ultrazohm/uz_ext_voltage_measurement_15kv/BOM_Spannungsmessung_15kV_Stückliste.pdf

Name | Description | Quantity | Manufacturer | Manufacturer Part Number | Supplyer | Supplier Part Number
Kondensatoren
1 µF | 50V 1uF X5R ±10% 0603 Multilayer Ceramic Capacitors MLCC - SMD/SMT ROHS | 13 | Samsung | CL10A105KB8NNNC | Mouser | 187-CL10A105KB8NNNC
1600 pF | Capacitor 1206, 25V, 1600pF, X8R, 10% | 2 | KEMET | C1206C162K3HACTU | Mouser | 80-C1206C162K3HACTU
15 pF | Capacitor 0805, 25 VDC, 15 pF, X7R | 2 | Kyocera AVX | 08053C150KAT2A | Mouser | 581-08053C150KAT2A
1000 pF | Capacitor 1206, 200VDC, 1000pF, C0G, 5% | 150 | KEMET | C1206C102J2GACTU | Mouser | 80-C1206C102J2G
1 µF | Capacitor 1206, 25V, 1uF, X7R, 5% | 2 | KEMET | C1206C105J3RACAUTO | Mouser | 80-C1206C105J3RCAUTO
100 nF | Capacitor 0603, 6.3 VDC, 100 nF, X5R | 4 | KEMET | C0603C104K9PACTU | Mouser | 80-C0603C104K9P
82k | SMD resistor 82Kohms .1% 25ppm | 150 | Vishay Dale | TNPW120682K0BEEA | Mouser | 71-TNPW120682K0BEEA
10R | SMD 1/10watt 10ohms 1% | 2 | Vishay | CRCW060310R0FKTA | Mouser | 71-CRCW0603-10
82R | SMD resistor 1/4W 82 ohm .1% 25ppm | 2 | Yageo | RT1206BRD0782RL | Mouser | 603-RT1206BRD0782RL
49R9 | 100mW Thick Film Resistors ±100ppm/℃ ±1% 49.9Ω 0603 Chip Resistor - Surface Mount ROHS | 2 | Yageo | RC0603FR-0749R9L | Mouser | 603-RC0603FR-0749R9L
3k 0.1% | Resistor - SMD 1206 3.0Kohm 0.1% 25ppm | 2 | Panasonic | ERA-8AEB302V | Mouser | 667-ERA-8AEB302V
1k 0.1% | Resistor - SMD 1206 1.0Kohm 0.1% 15ppm | 2 | Panasonic | ERA-8APB102V | Mouser | 667-ERA-8APB102V
1SS356VMFHTE-17 | Dioden (Allzweck, Leistung, Schaltung) SWITCHING DIODE 35V | 4 | Rohm | 1SS356VMFHTE-17 | Mouser | 755-1SS356VMFHTE-17
SI8920BC-IP | Integrated Circuit - Trennverstärker Isolated analog amplifier with 200 mV input | 1 | Silicon Labs | SI8920BC-IP | Mouser | 634-SI8920BC-IP
ADA4940-1ARZ-R7 | Differential ADC Driver | 1 | Analog Devices | ADA4940-1ARZ-R7 | Mouser | 584-ADA4940-1ARZ-R7
EC3SAW-24S05HP | Isolierte DC/DC-Wandler – Durchsteckmontage 3W 9-36Vin 5Vout 600mA | 1 | Cincon | EC3SAW-24S05HP | Mouser | 418-EC3SAW-24S05HP
EC3SAW-24D05HP | Isolierte DC/DC-Wandler – Durchsteckmontage 3W 9-36Vin +/-5Vout 300mA | 1 | Cincon | EC3SAW-24D05HP | Mouser | 418-EC3SAW-24D05HP
M8 Connector | 7460719_M8 | 2 | Wurth Electronics | 7460719 | Mouser | 710-7460719
BNC-Buchse | BNC5-J-P-GN-ST-TH2D | 2 | Samtec | BNC5-J-P-GN-ST-TH2D | Mouser | 200-BNC5JPGNSTTH2D
RJ45 Connector | RJHSE-5381 | 1 | Amphenol Commercial RJHSE-5381 | | Mouser | 523-RJHSE-5381
Laborbuchse red | FCR7350B, 1000V, 24A, RED | 2 | Cliff | FCR7350R | Farnell | 1854508
Laborbuchse Schwarz | FCR7350B, 1000V, 24A, BLACK | 2 | Cliff | FCR7350B | Farnell | 1854507

Stückliste Spannungsmessung 15 kV

Widerstände

Diode

IC's

DC/DC Wandler

Connectors
