ultrazohm/uz_ext_voltage_measurement_15kv/00_Stückliste_Spannungsmessung_15kV.xlsx

Stückliste Projekt Spannungsmessung 15 kV
Name | Description | Stk. | Manufacturer | Manufacturer Part Number | Supplier | Supplier Part Number | Euro/Stk. | Stk. Total | Lieferbar/Bestellt | geliefert
Kondensatoren |  |  |  |  |  |  |  |  | 3
1 µF | 50V 1uF X5R ±10% 0603 Multilayer Ceramic Capacitors MLCC - SMD/SMT ROHS | 13 | Samsung | CL10A105KB8NNNC | Mouser | 187-CL10A105KB8NNNC | 0.13 | 1.64 |  | 39
1600 pF | Capacitor 1206, 25V, 1600pF, X8R, 10% | 2 | KEMET | C1206C162K3HACTU | Mouser | 80-C1206C162K3HACTU | 0.16 | 0.32 |  | 6
15 pF | Capacitor 0805, 25 VDC, 15 pF, X7R | 2 | Kyocera AVX | 08053C150KAT2A | Mouser | 581-08053C150KAT2A | 0.19 | 0.38 |  | 6
1000 pF | Capacitor 1206, 200VDC, 1000pF, C0G, 5% | 150 | KEMET | C1206C102J2GACTU | Mouser | 80-C1206C102J2G | 0.24 | 36.45 | -> bei JLC Global Sourcing bestellen: Distributor TME (300 stk ~ 22$)
1 µF | Capacitor 1206, 25V, 1uF, X7R, 5% | 2 | KEMET | C1206C105J3RACAUTO | Mouser | 80-C1206C105J3RCAUTO | 0.35 | 0.70 |  | 6
100 nF | Capacitor 0603, 6.3 VDC, 100 nF, X5R | 4 | KEMET | C0603C104K9PACTU | Mouser | 80-C0603C104K9P | 0.16 | 0.65 |  | 12
Diode
1SS356VMFHTE-17 | Dioden (Allzweck, Leistung, Schaltung) SWITCHING DIODE 35V | 4 | Rohm | 1SS356VMFHTE-17 | Mouser | 755-1SS356VMFHTE-17 | 0.387 | 1.548 |  | 12
Widerstände
82k | SMD resistor 82Kohms .1% 25ppm | 150 | Vishay Dale | TNPW120682K0BEEA | Mouser | 71-TNPW120682K0BEEA | 0.319 | 47.85 | bei Mouser bestellt | 320
10R | SMD 1/10watt 10ohms 1% | 2 | Vishay | CRCW060310R0FKTA | Mouser | 71-CRCW0603-10 | 0.117 | 0.234 |  | 6
82R | SMD resistor 1/4W 82 ohm .1% 25ppm | 2 | Yageo | RT1206BRD0782RL | Mouser | 603-RT1206BRD0782RL | 0.585 | 1.17 |  | 10
49R9 | 100mW Thick Film Resistors ±100ppm/℃ ±1% 49.9Ω 0603 Chip Resistor - Surface Mount ROHS | 2 | Yageo | RC0603FR-0749R9L | Mouser | 603-RC0603FR-0749R9L | 0.09 | 0.18 |  | 10
3k 0.1% | Resistor - SMD 1206 3.0Kohm 0.1% 25ppm | 2 | Panasonic | ERA-8AEB302V | Mouser | 667-ERA-8AEB302V | 0.432 | 0.864 |  | 10
1k 0.1% | Resistor - SMD 1206 1.0Kohm 0.1% 15ppm | 2 | Panasonic | ERA-8APB102V | Mouser | 667-ERA-8APB102V | 0.801 | 1.602 |  | 6
IC's
SI8920BC-IP | Integrated Circuit - Trennverstärker Isolated analog amplifier with 200 mV input | 1 | Silicon Labs | SI8920BC-IP | Mouser | 634-SI8920BC-IP | 5.91 | 5.91 |  | 3
ADA4940-1ARZ-R7 | Differential ADC Driver | 1 | Analog Devices | ADA4940-1ARZ-R7 | Mouser | 584-ADA4940-1ARZ-R7 | 5.26 | 5.26 |  | 3
Spannungsversorgung
EC3SAW-24S05HP | Isolierte DC/DC-Wandler – Durchsteckmontage 3W 9-36Vin 5Vout 600mA | 1 | Cincon | EC3SAW-24S05HP | Mouser | 418-EC3SAW-24S05HP | 11,88 | 11,88 | hier noch auf lager
EC3SAW-24D05HP | Isolierte DC/DC-Wandler – Durchsteckmontage 3W 9-36Vin +/-5Vout 300mA | 1 | Cincon | EC3SAW-24D05HP | Mouser | 418-EC3SAW-24D05HP | 11,88 | 11,88 |  | 1
Verbindungsstücke
M8 Connector | 7460719_M8 | 2 | Wurth Electronics | 7460719 | Mouser | 710-7460719 | 6.11 | 12.22 |  | 4
BNC-Buchse | BNC5-J-P-GN-ST-TH2D | 2 | Samtec | BNC5-J-P-GN-ST-TH2D | Mouser | 200-BNC5JPGNSTTH2D | 7.58 | 15.16 | Footprint auf PCB korrigiert! | 3
RJ45 Connector | RJHSE-5381 | 1 | Amphenol Commercial | RJHSE-5381 | Mouser | 523-RJHSE-5381 | 1.85 | 1.85 |  | 3
Laborbuchse red | FCR7350B, 1000V, 24A, RED | 2 | Cliff | FCR7350R | Farnell | 1854508 | 6.04 | 12.08 | noch da
Laborbuchse Schwarz | FCR7350B, 1000V, 24A, BLACK | 2 | Cliff | FCR7350B | Farnell | 1854507 | 6.04 | 12.08 | noch da
 |  |  |  |  |  | Summe Bauteile |  | 158.15 | für Bauteile pro Platine
 |  |  |  |  |  | Platine bei JLC |  | 112 | mit Bestückung
Platine bei JLC |  |  |  |  |  | Mouser |  | 121.70 | €
 |  |  |  |  |  | Summe |  |  | für zwei bestückte Platinen
 |  |  |  |  |  | Kreditkarte |  | 134 | $
Sonstiges |  |  |  |  |  |  |  |  |  | geliefert
Abstandshülsen Kunststoff | M3 x M3, Länge 15mm, Nylon, Außen/Innen, Sechskant M3 M3, 5.6mm |  | Link | https://de.rs-online.com/web/p/abstandshalter/0325772 |  |  |  |  | 50 stk. ~20 €
Plexiglasumhausung |  |  |  |  |  |  |  |  | kümmert sich Fabian G
Ersatzwiderstände (wenn Trennverstärker entfällt) |  |  |  |  |  |  |  |  |  | geliefert
499R | SMD 499ohms .1% 25ppm | 10 | Vishay | TNPW1206499RBEEA | Mouser | 71-TNPW1206499RBEEA | 0.57 | 5.7 |  | 6
4.99k | SMD 1206 4.99Kohms 0.1% | 10 | Panasonic | ERA-8APB4991V | Mouser | 667-ERA-8APB4991V | 0.8 | 8 |  | 6
neue Kondensatoren für Tiefpassfilter (weil falsch bestellt)
2 nF | Capacitor 25V 2000pF X8R 1206 1% | 2 | Kemet | C1206C202F3HACTU | Mouser | 80-C1206C202F3HACTU
