ultrazohm/uz_ext_voltage_measurement_15kv/Projekt_Spannungsmessung.pdf

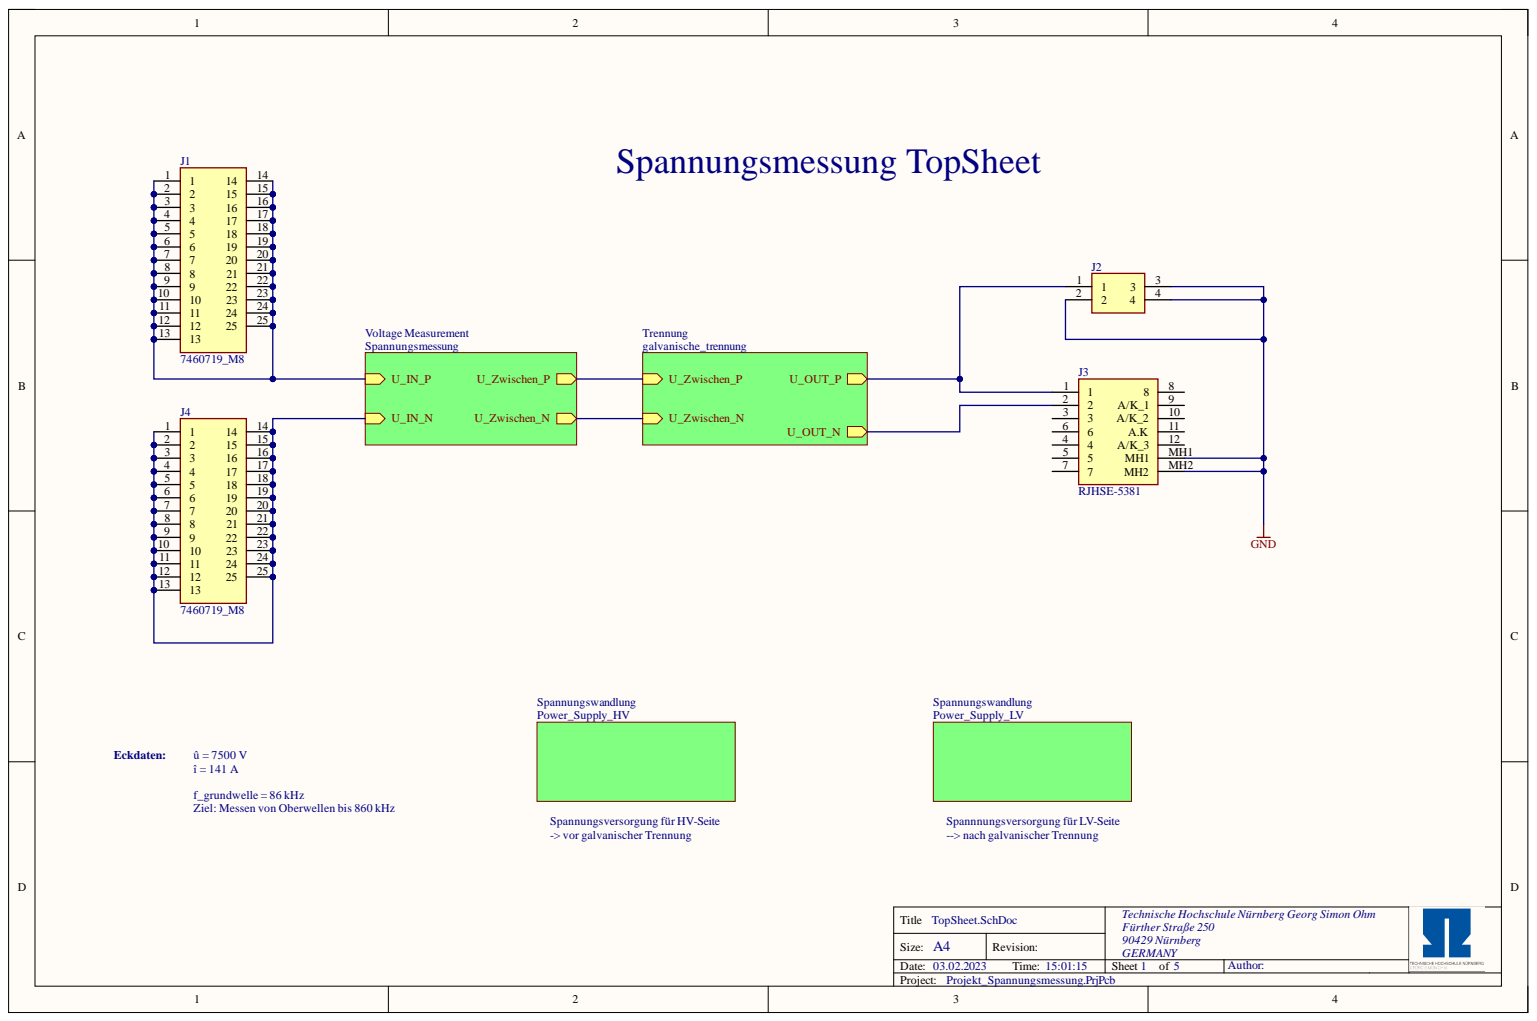
[picture p1: page 1]

2 | 1 5
3 | 1 6
4 | 1 7
5 | 1 8
6 | 1 9
7 | 2 0
8 | 2 1

1 1 | 2 4
1 2 | 2 5

3 | | 1 0

9 | 2 2
1 0 | 2 3

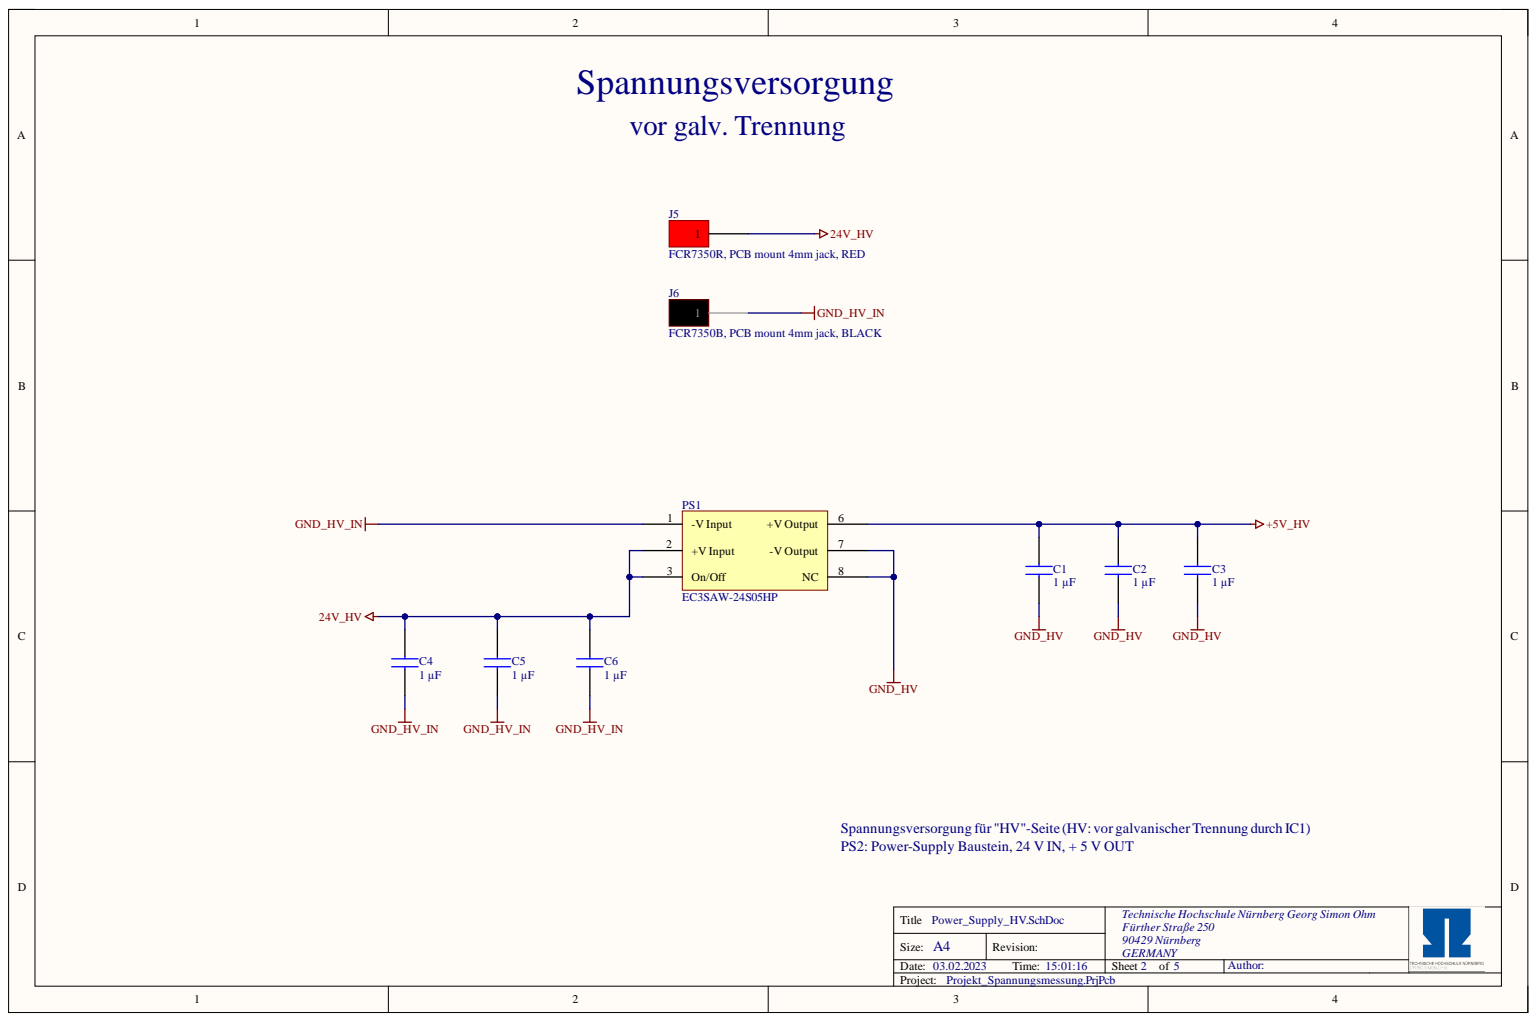
[picture p2: page 2]

Spannungsversorgung für "HV"-Seite (HV: vor galvanischer Trennung durch IC1)
PS2: Power-Supply Baustein, 24 V IN, + 5 V OUT

Technische Hochschule Nürnberg Georg Simon Ohm
Fürther Straße 250
90429 Nürnberg
GERMANY

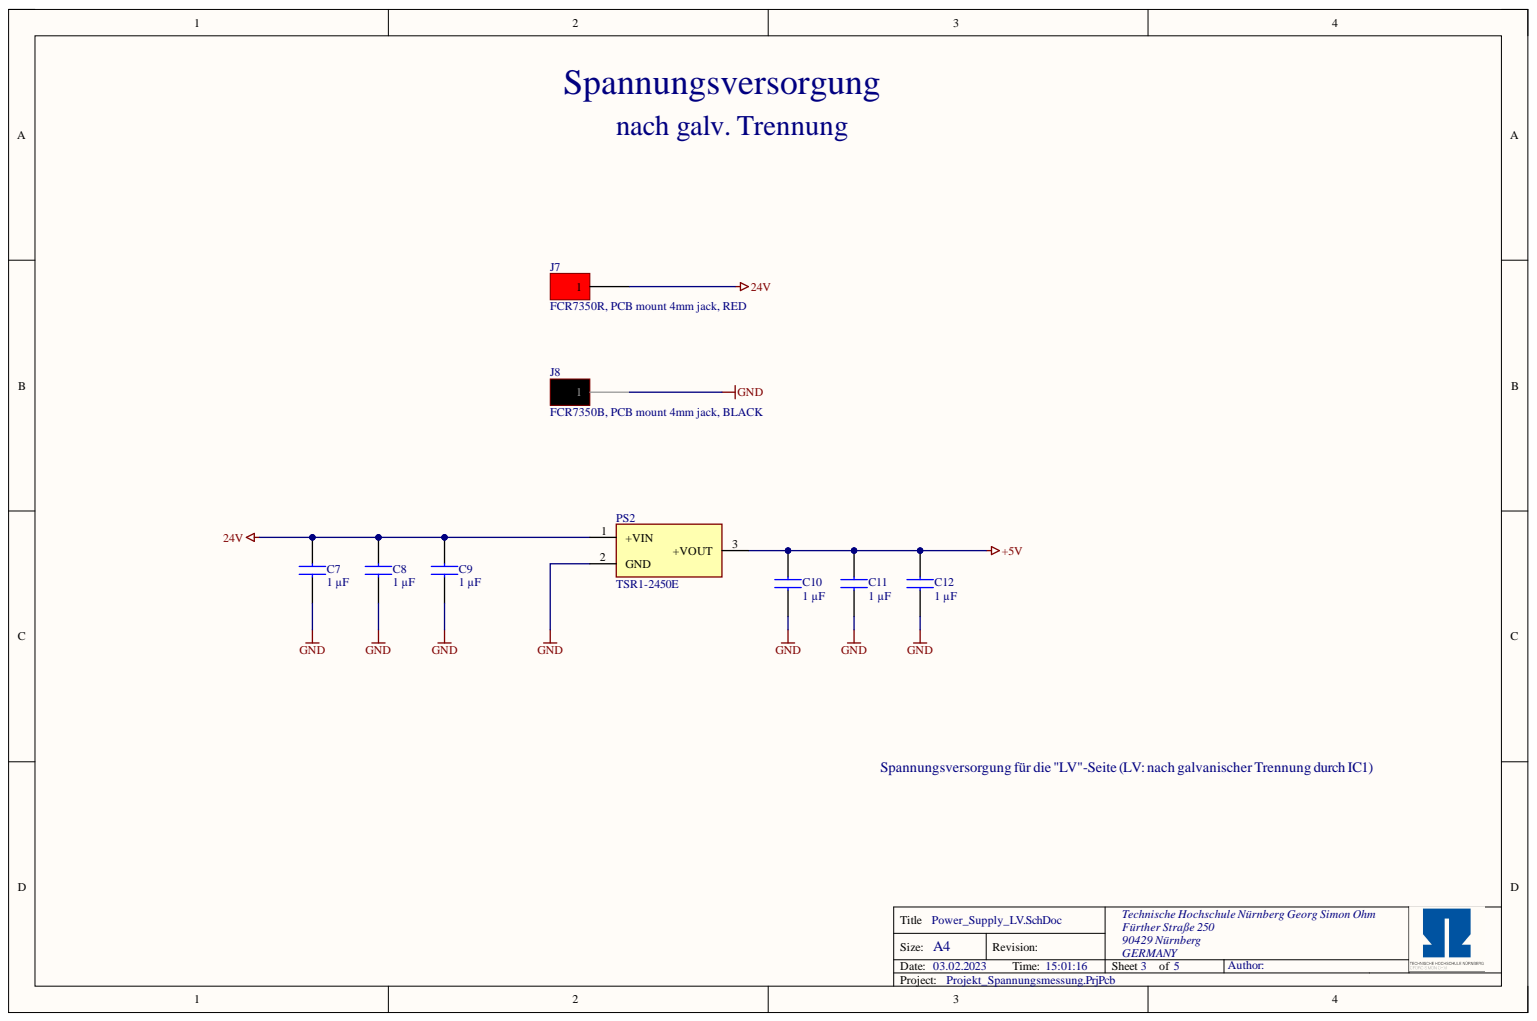
[picture p3: page 3]

Spannungsversorgung für die "LV"-Seite (LV: nach galvanischer Trennung durch IC1)

Technische Hochschule Nürnberg Georg Simon Ohm
Fürther Straße 250
90429 Nürnberg
GERMANY

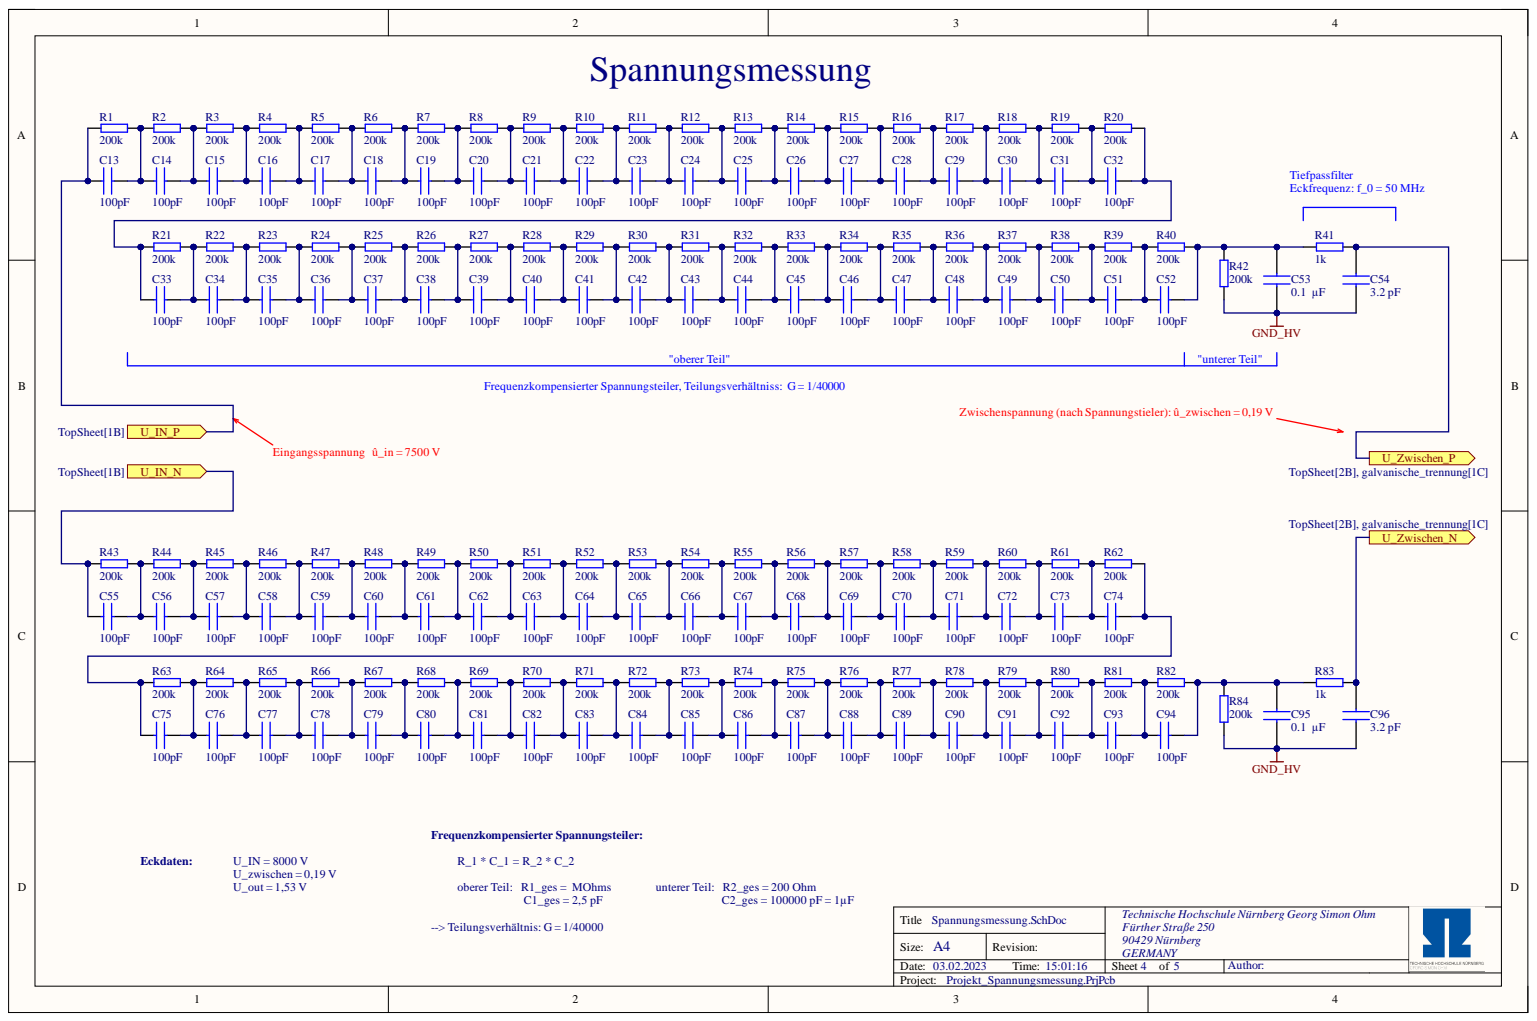
[picture p4: page 4]

Technische Hochschule Nürnberg Georg Simon Ohm
Fürther Straße 250
90429 Nürnberg
GERMANY

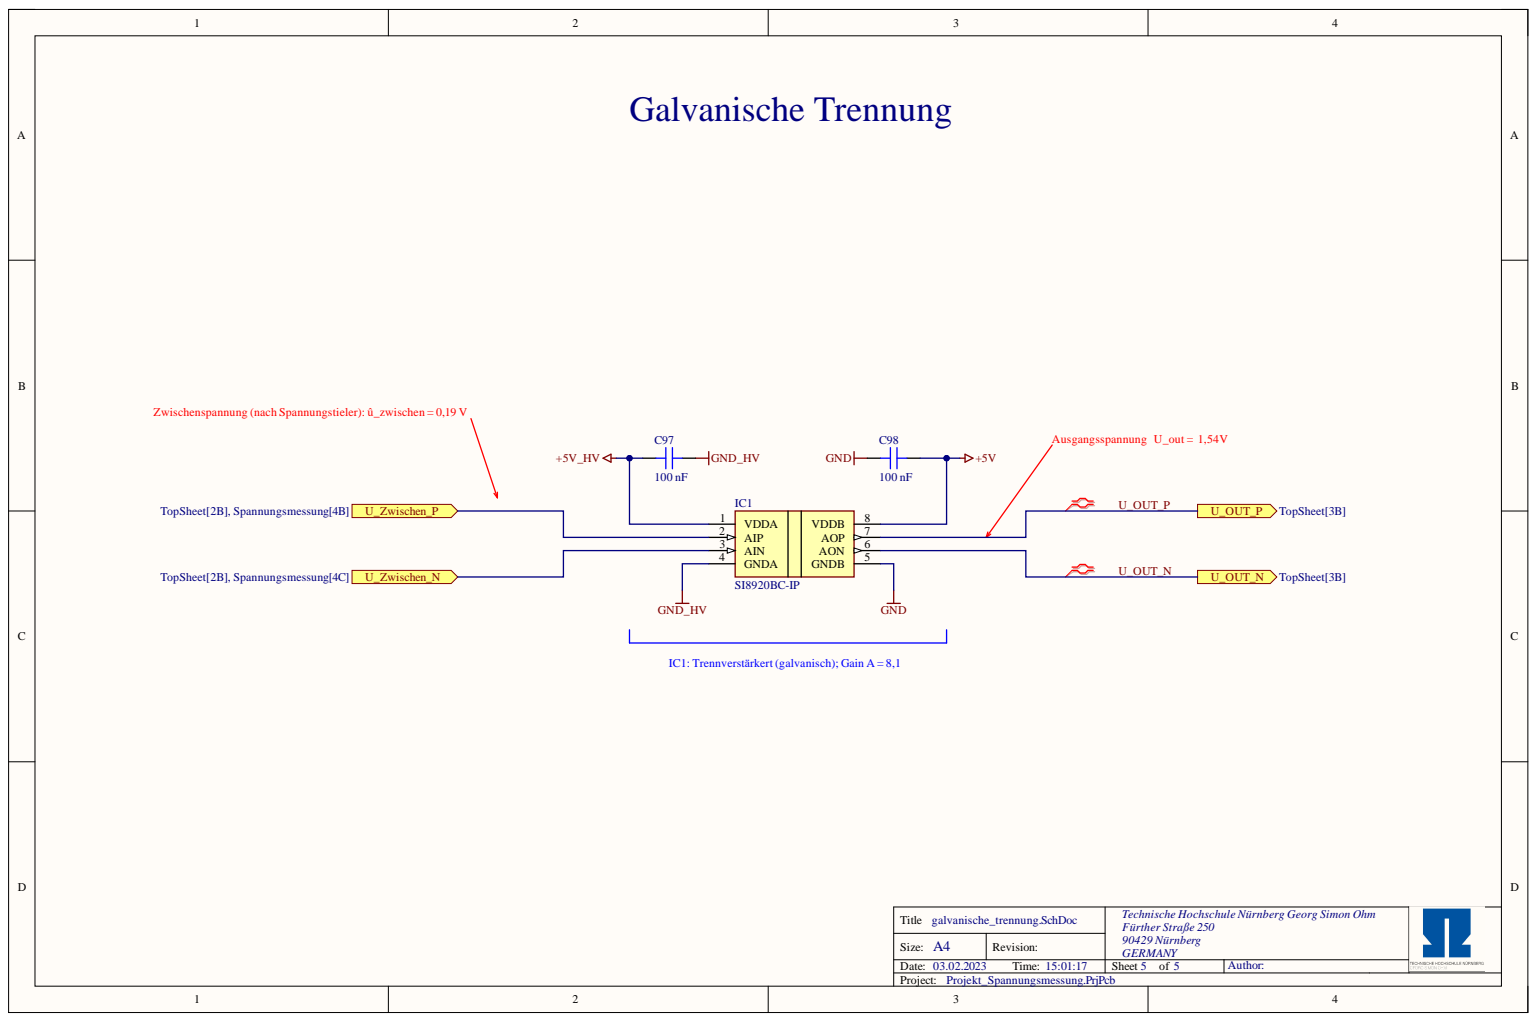
[picture p5: page 5]

VDDA 1

AIN 3

Technische Hochschule Nürnberg Georg Simon Ohm
Fürther Straße 250
90429 Nürnberg
GERMANY

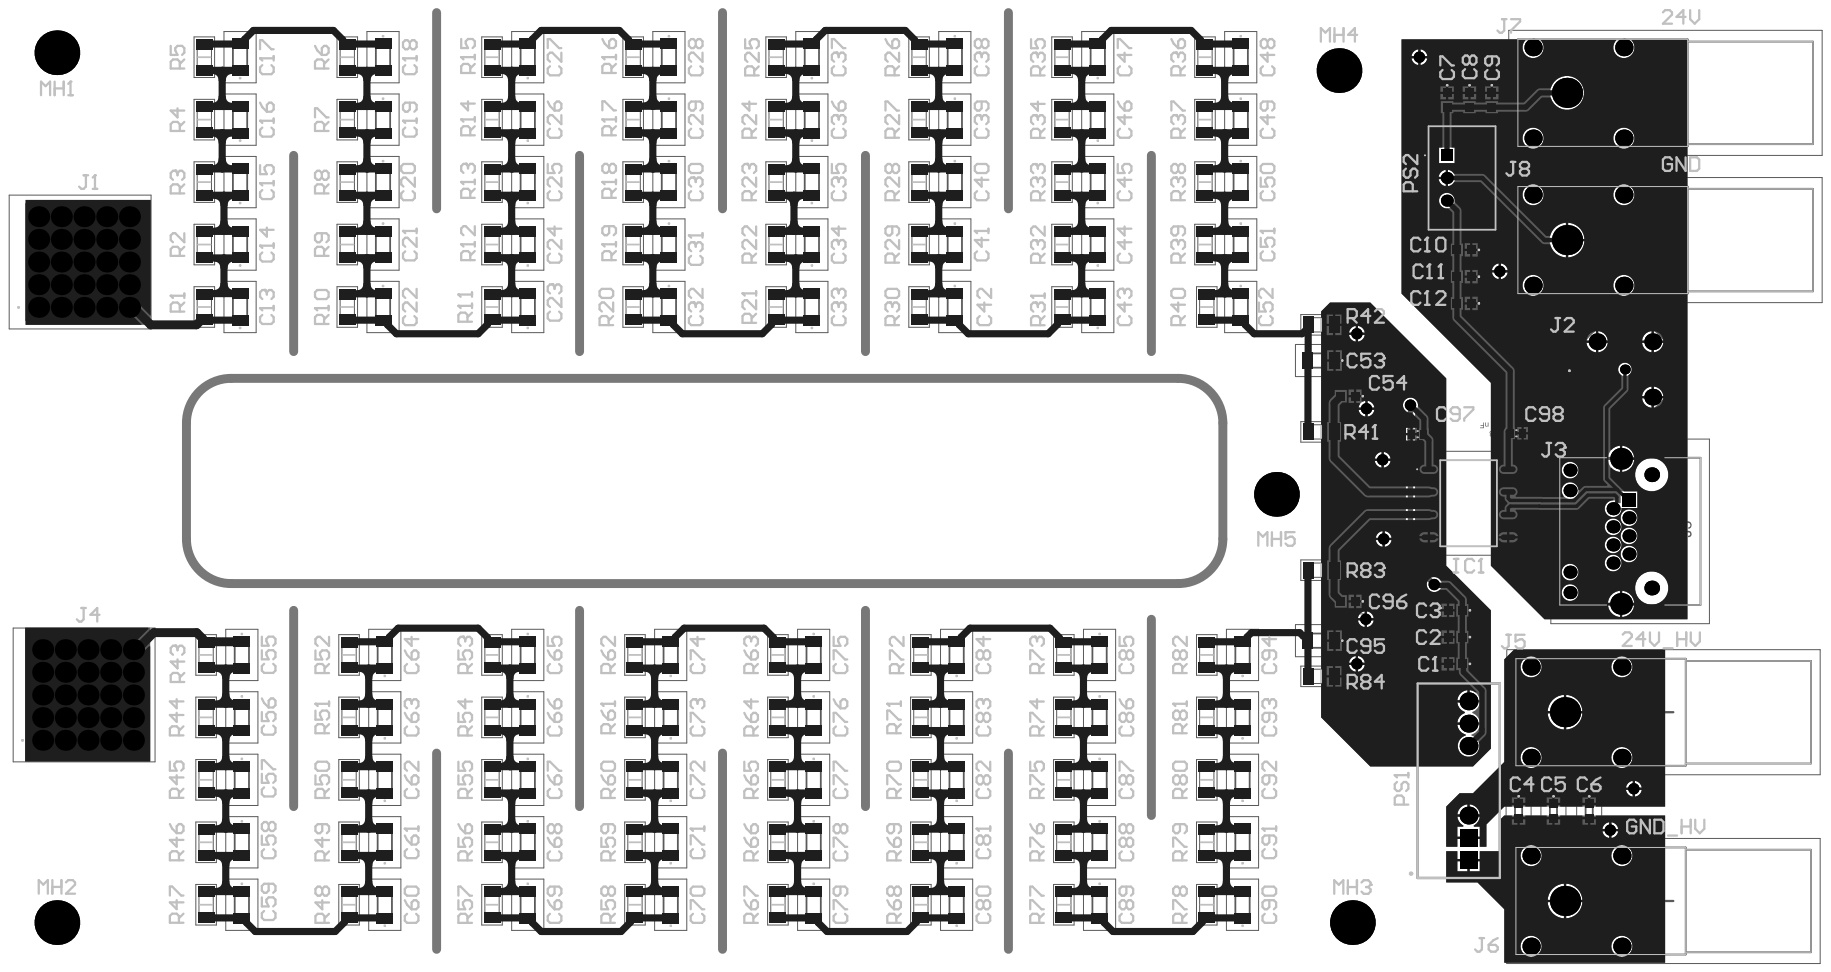
[picture p6: page 6]
