ultrazohm/uz_ext_voltage_measurement_15kv/Project Outputs for Projekt_Spannungsmessung_15kV/3D_View_Top_Projekt_Spannungsmessung_15kV_Default_Rev02.PDF

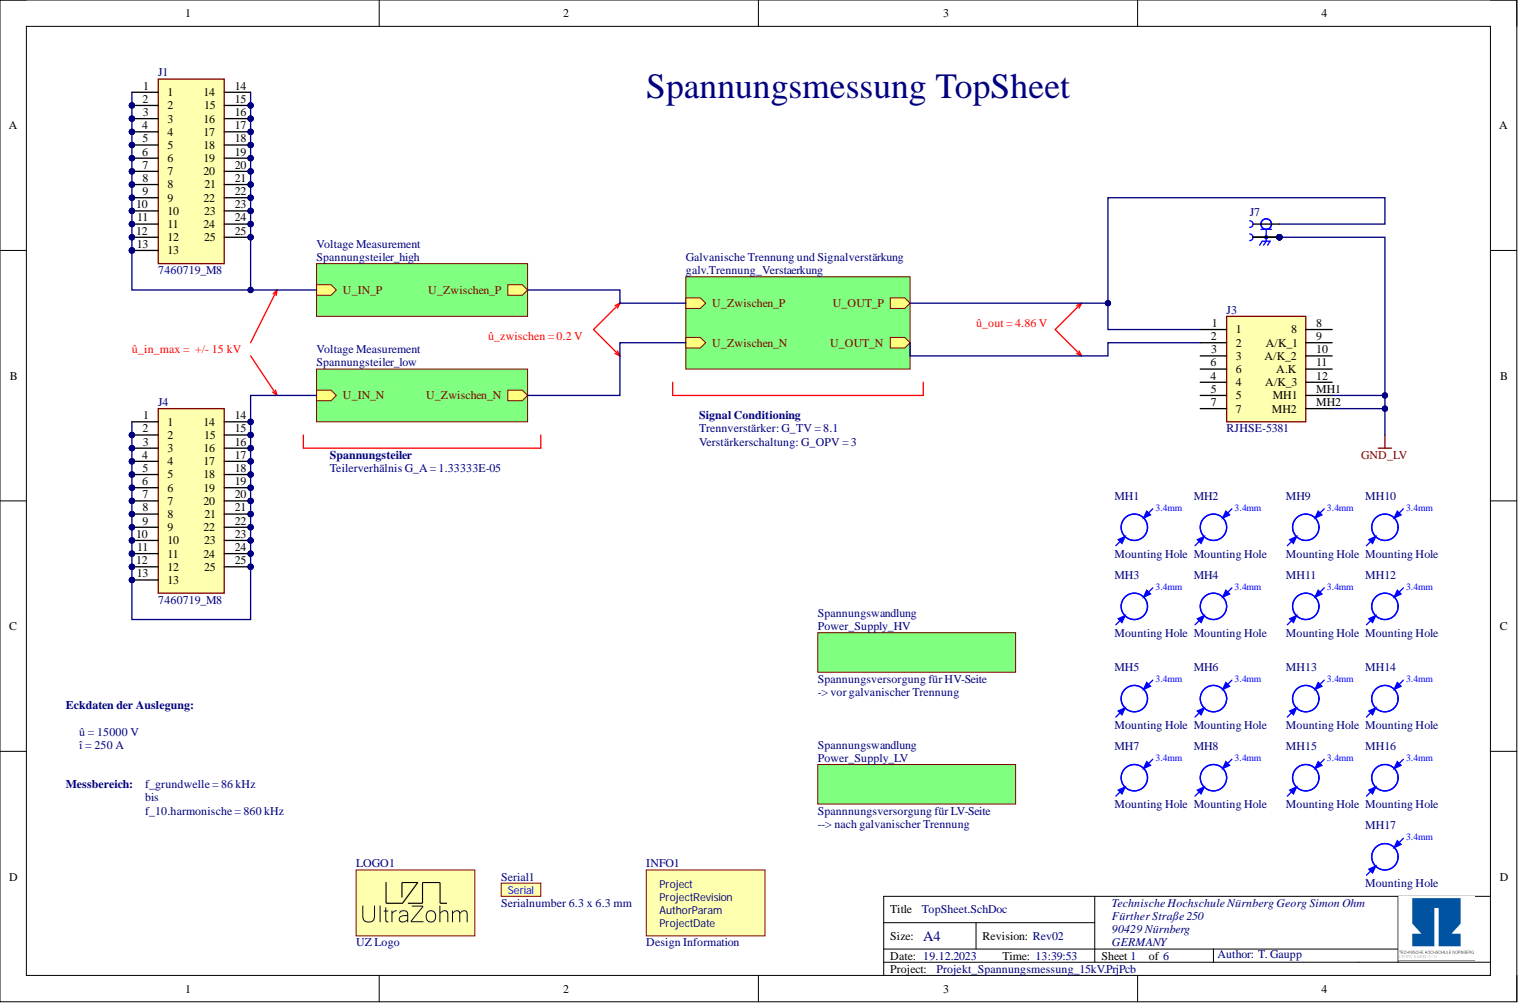
[picture p7: page 1]

Galvanische Trennung und Signalverstärkung
galv.Trennung_Verstaerkung

Spannungsversorgung für HV-Seite
-> vor galvanischer Trennung

Spannnungsversorgung für LV-Seite
--> nach galvanischer Trennung

Technische Hochschule Nürnberg Georg Simon Ohm
Fürther Straße 250
90429 Nürnberg
GERMANY

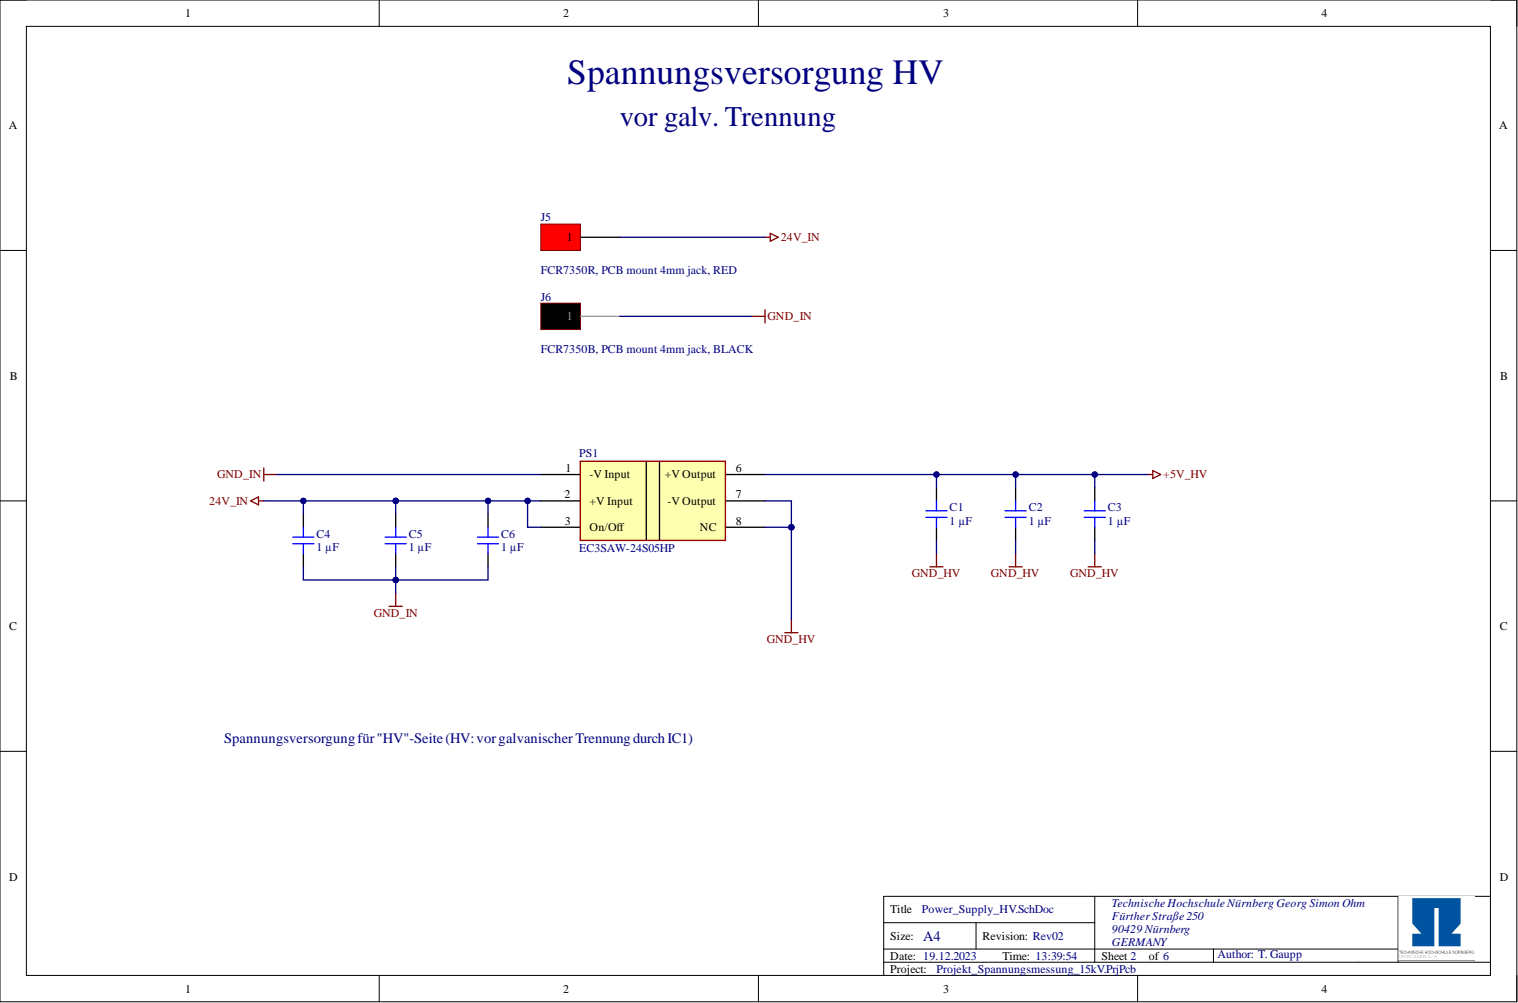
[picture p8: page 2]

FCR7350R, PCB mount 4mm jack, RED

FCR7350B, PCB mount 4mm jack, BLACK

-V Input 1 | NC

+V Input 2

On/Off 3 | 8

Spannungsversorgung für "HV"-Seite (HV: vor galvanischer Trennung durch IC1)

Technische Hochschule Nürnberg Georg Simon Ohm
Fürther Straße 250

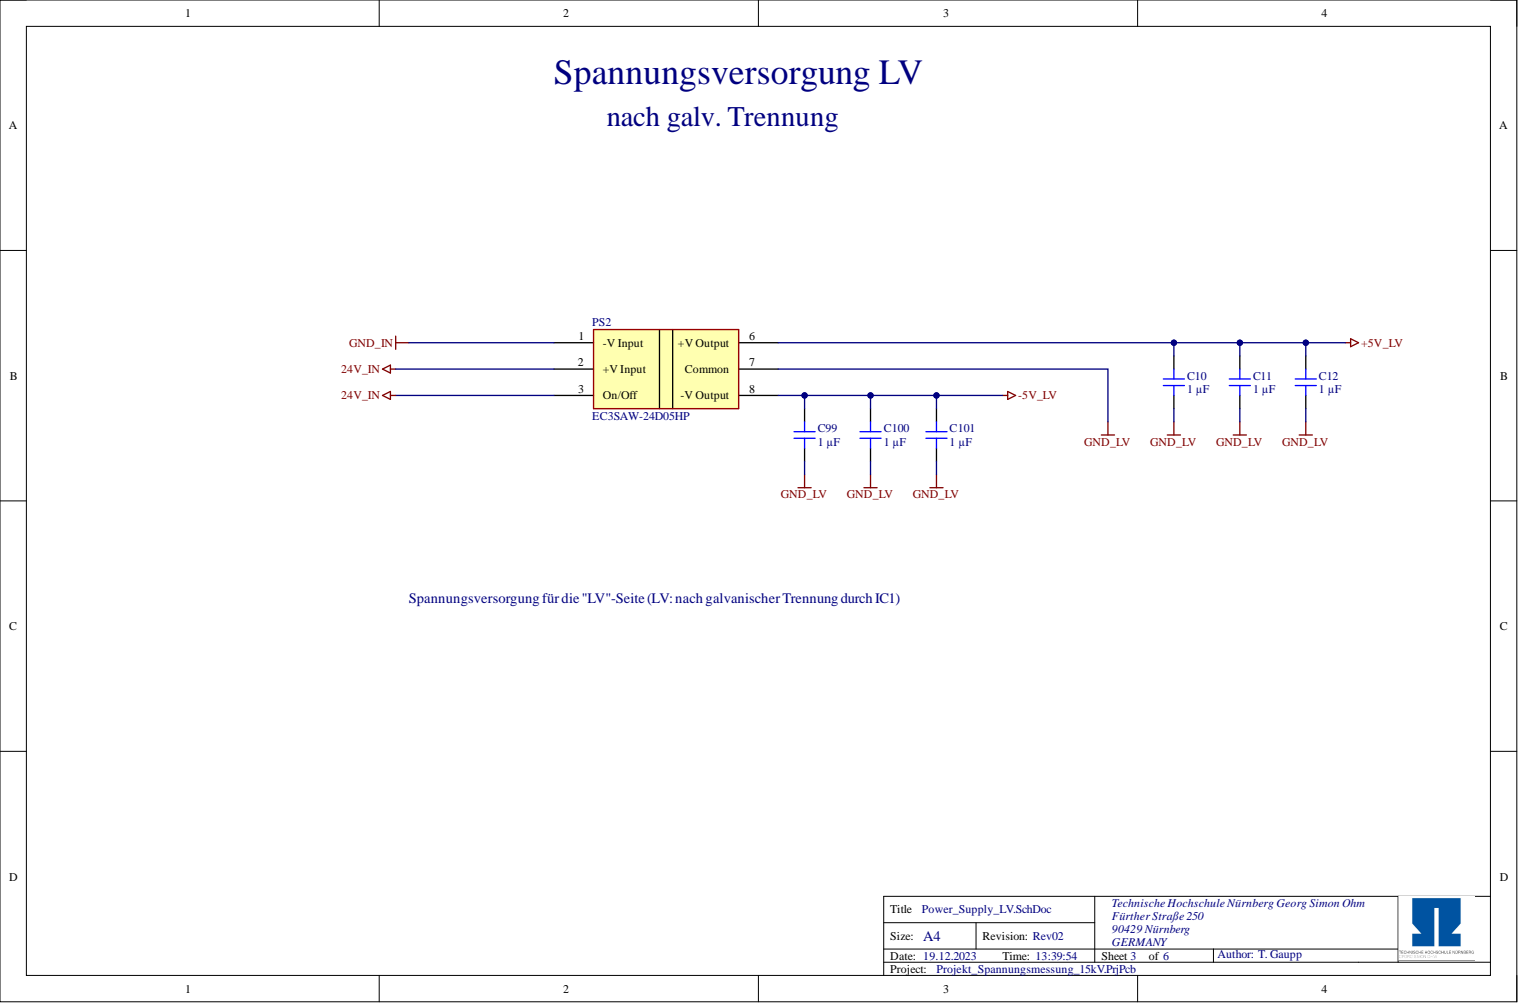
[picture p9: page 3]

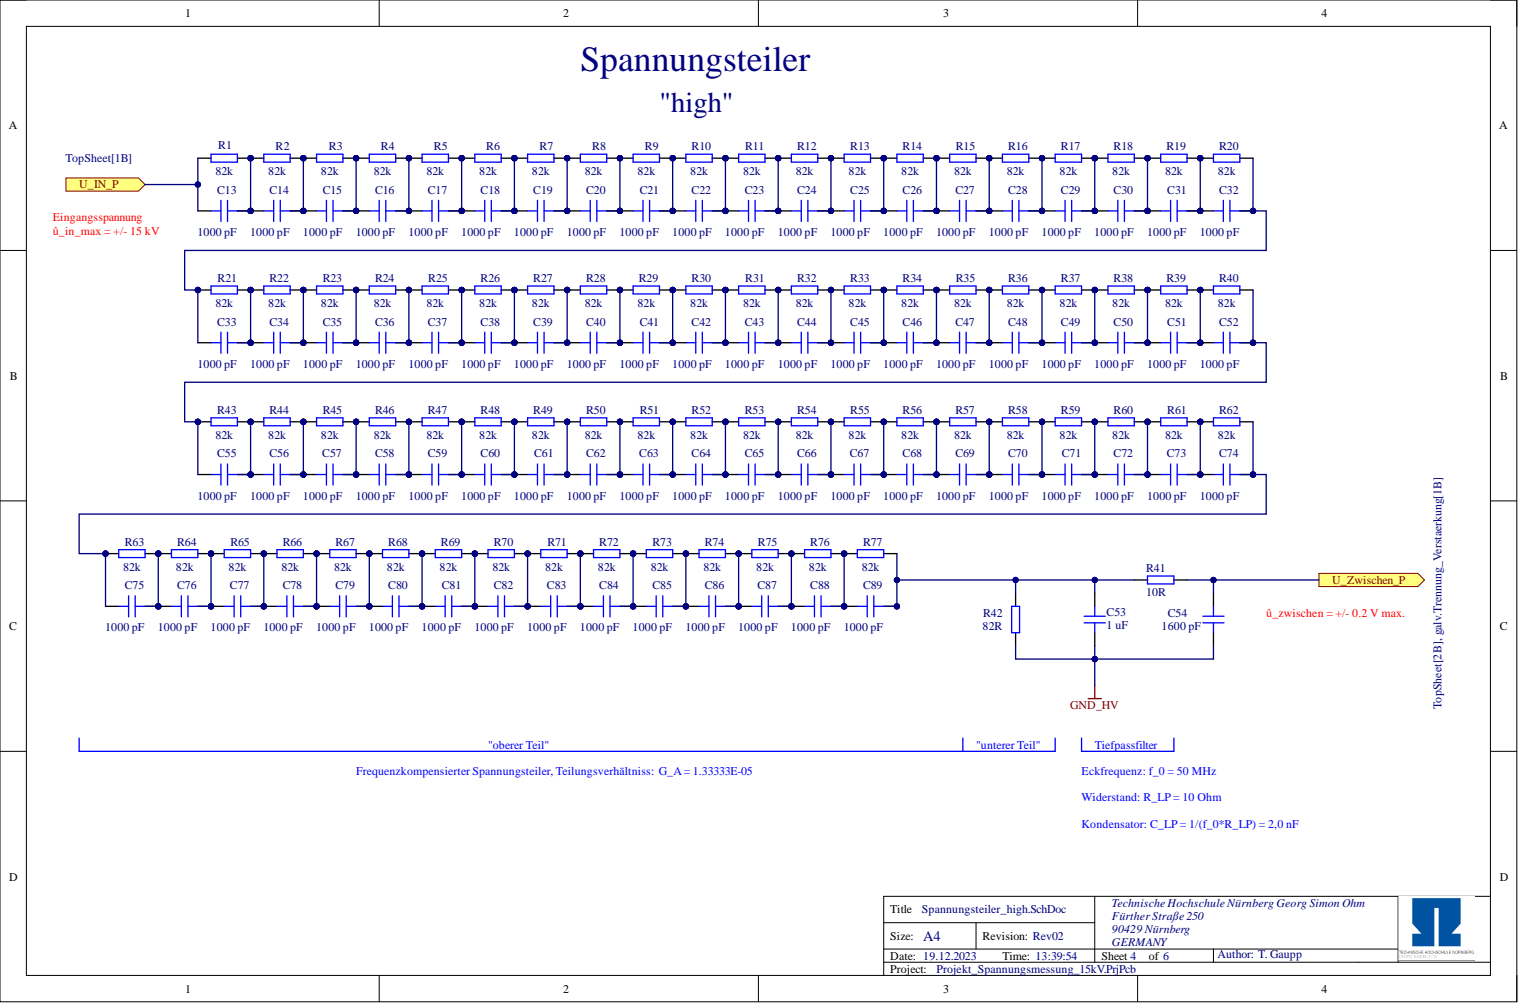
[picture p10: page 4]

Technische Hochschule Nürnberg Georg Simon Ohm
Fürther Straße 250

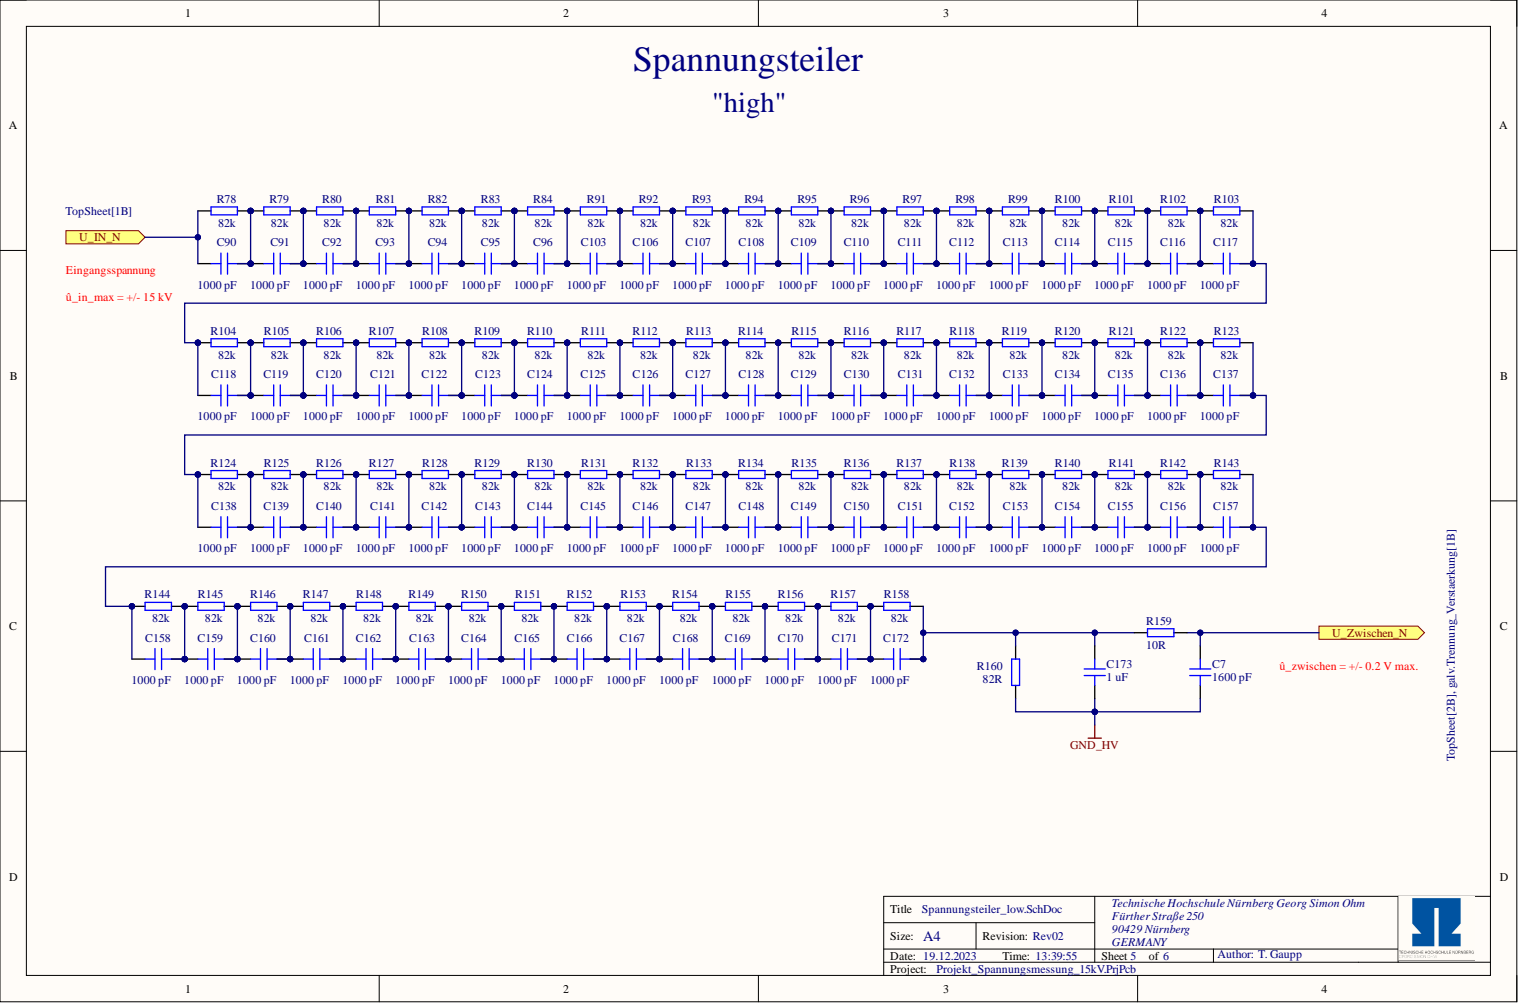
[picture p11: page 5]

Technische Hochschule Nürnberg Georg Simon Ohm
Fürther Straße 250

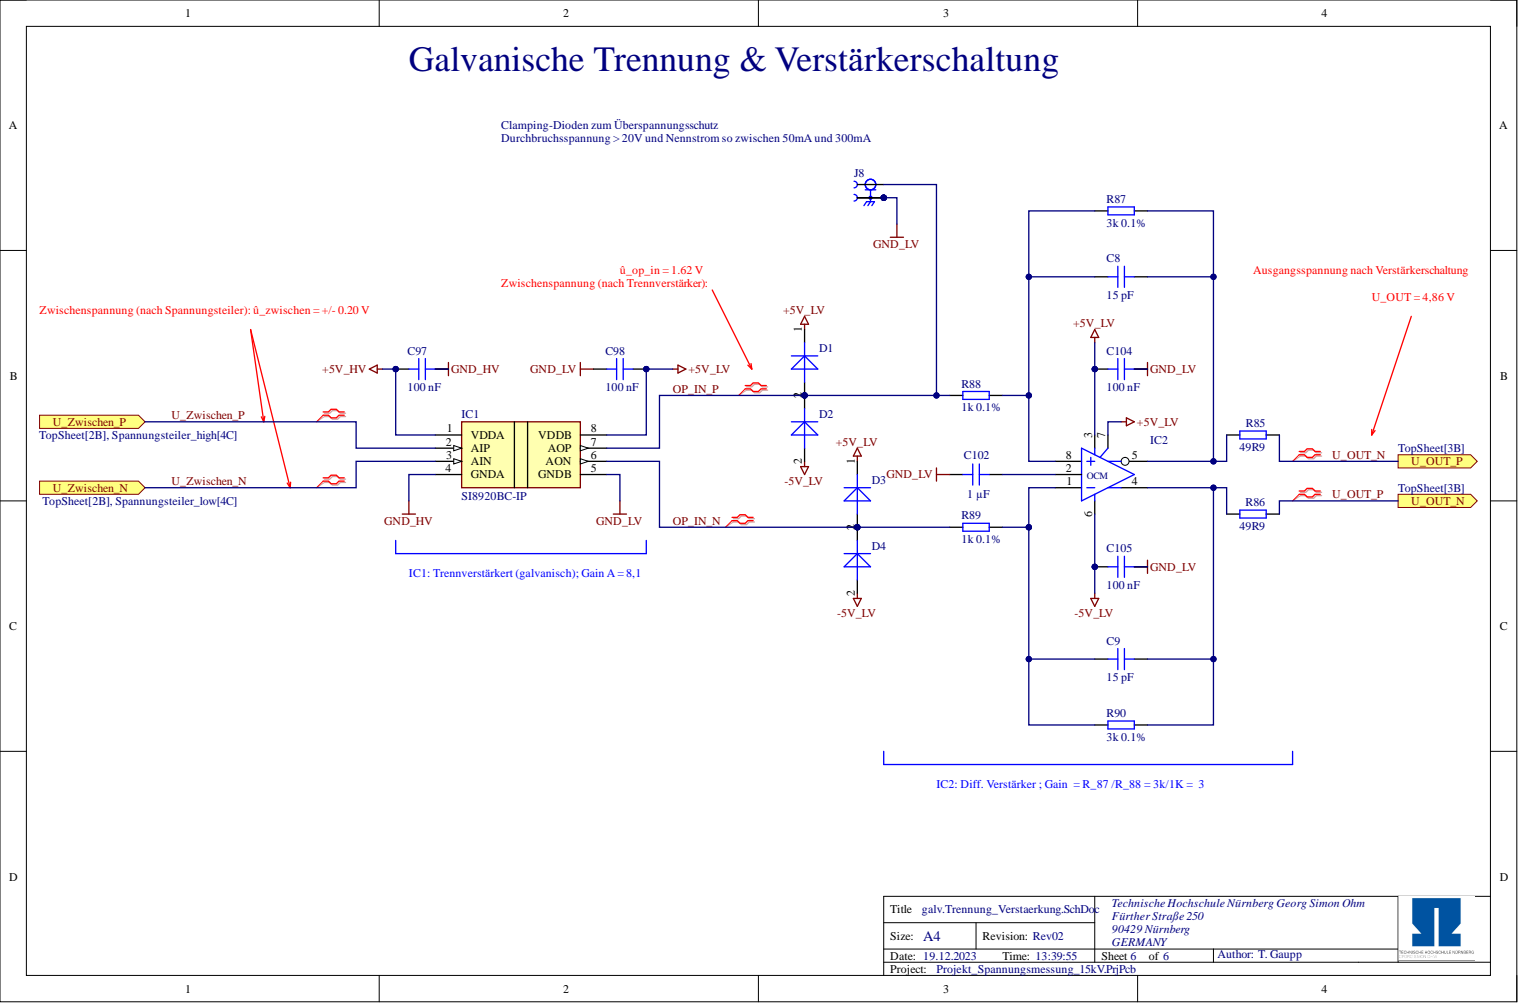
[picture p12: page 6]

Clamping-Dioden zum Überspannungsschutz
Durchbruchsspannung > 20V und Nennstrom so zwischen 50mA und 300mA

Technische Hochschule Nürnberg Georg Simon Ohm
Fürther Straße 250
