ultrazohm/uz_ext_voltage_measurement_15kv/(list of files, drawings)

Other design files:
Copy of Platine_Spannungsmessung.PcbDoc
galv.Trennung_Verstaerkung.SchDoc
Power_Supply_HV.SchDoc
Power_Supply_LV.SchDoc
Projekt_Spannungsmessung_15kV.PrjPcb
Spannungsteiler_high.SchDoc
Spannungsteiler_low.SchDoc
TopSheet.SchDoc
